Hoas0411/casa0014/(commit log)

2026-11-03 Add 。gitignore for exclude my password and account
2026-11-03 2.Kendama inspiration and early row/column LED sketch
2026-11-03 3.wire IMU with jumper cables and I2C data transmission
2026-11-03 3.map LED groups to find column layout on Vespera
2026-11-04 4.Add battery and button so it works without a USB cable
2026-11-04 4.Fix sensor on breadboard, level it, and add row/column motion modes
    [07.vespera_motion_toy.ino, RGBLED.ino, connections.ino]
2026-11-04 Add diagrams and LED animations, update README
